KuchTo/VU_Meter/(list of files, drawings)

Other design files:
VU_Meter.fzz
VU_Meter_teil 2.fzz
VU_Meter_Teil 3.fzz
