KuchTo/VU_Meter/(commit log)

2019-12-22 Description / Assembly Directives
2019-12-22 Fritzing Schematics
    [VU_Meter_Teil 3.fzz, VU_Meter_teil 2.fzz]
